tbr60702/Sensors-Final-Project/Final Report Taylor Reese.pdf

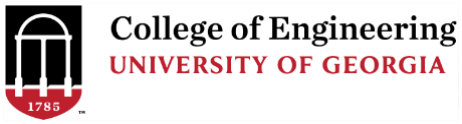
[picture p1: figure]

# Final Project Report ELEE 4230

## Taylor Reese

Final Project Report

ELEE 4230

Date: 12/05/21
Page 2 of 17

1 Table of Contents

ELEE 4230

Page 3 of 17

2 Abstract

New smoker style grills, such as a Recteq, come with controllers for grills installed on them from the factory. These controllers allow the user to set grill temperatures for the grill to maintain on its own from that point forward, as well as monitor food temperatures. The goal of this project is to create a sensor system that replicates this functionality for older smokers that did not come equipped with electronic controllers. Therefore, the goal is to create a controller that senses food and grill temperatures and can use those readings to maintain a set grill temperature without runaway overheating or choked out coals.

A fully working controller was created using an Arduino mega, motor shield, and LCD screen with a keypad for processing, control, and user interface. Two type K thermocouples were used to sense temperatures, and a fan was used to control air flow to the coals burning inside the smoker. The controller has a functioning user interface that allows users to input grill and food temperature setpoints and displays the food and grill temperatures during operation. The grill controller uses the readings to gradually adjust the grill temperature up and down to prevent runaway heating or cooling conditions by changing fan run settings based on the temperature readings.
3 Problem Identification
Unlike some new and extremely expensive grills, many
smokers or grills such as a Big Green Egg (See Figure 1) do
not come with any type of electronic controls. These types of grills rely on the person smoking on their grill to spend countless hours beside the grill adjusting the draft air intakes (See Draft Door in Figure 1) and exhaust ports (See Top in figure 1 to maintain the perfect temperature for their smoke. This is far from ideal and can allow for the grill to get way too hot or cold, ruining the cook, if it is ignored for even a few minutes. So, the problem this project attempts to solve is the instability built into smokers without any kind of electronic control. Expanding that out into a more detailed problem list,
nonelectric smokers cannot:
1. Sense food temperature

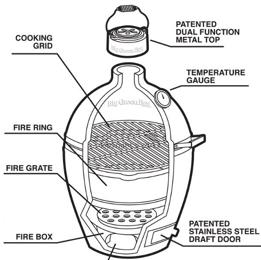
[picture p2: figure]

2. Sense grill temperature | Figure 1: Big Green Egg
3. Use food and grill temperatures to adjust air flow to coals being used to fuel the smoker.

To solve this problem, a portable/removable grill controller needs to be created that uses at least two sensors to read the food and grill temperatures, as well as have a method of determining what temperature the grill should be and controlling air flow to the coals to maintain that temperature.

ELEE 4230

Page 4 of 17

4 Sensor and Actuator Selection

As established in the problem identification section, the grill controller, at minimum, needs to sense the food temperature, grill temperature, and grill temperature setpoint. This grill controller will also sense a food temperature setpoint. Using those things, the grill controller has to control the airflow to the coals to maintain the temperature setpoint. Now, knowing what has to be sensed, the parameters can be outlined. For the food temperature sensor, it must be composed of a non-corrosive material in order to penetrate into the food without damaging itself of contaminating the food. It also must be able to sense temperatures up to approximately 200 degrees Fahrenheit and survive in environments up to 400 degrees Fahrenheit. For the grill temperature sensor, it must be able to survive in and read temperatures up to 400 degrees Fahrenheit. For sensing the grill and food temperature setpoints, a physical interaction with visual feedback must occur for a person to set each temperature.

4.1 Food and Grill Temperature Sensors

For sensing food temperatures, there were three serious options:

Measurand | Sensor Family | Sensor
Food Temperature | Resistive | RTD
| Resistive | Thermistor
| Self-Generating | Thermocouple

At this point, the thermistor is the least viable of the three sensors due to the ease of manufacturing a RTD or thermocouple into a long probe for penetrating into foods. That combined with the increased durability and range of temperature sensing in RTDs and Thermocouples eliminated thermistors for food and grill temp sensing. So, the options become:

Measurand | Sensor Family | Sensor
Food Temperature | Resistive | RTD
| Self-Generating | Thermocouple
At this point, the interchangeability and cheapness of thermocouples if one was to one day fail whereas a RTD is more expensive and less interchangeable became the deciding factor in choosing thermocouples of RTD’s. Withing thermocouples are several different types. For this project, K type include the measurand range and is the most widely available, so it was chosen.
For sensing the grill temperature, the Adafruit Accessories Thermocouple Type-K (See image 2) was chosen because it can work up to 900 degrees Fahrenheit and survive in the environment of a smoker. For sensing the food temperature, a Prosense Thermocouple with a 6” probe was chosen to because the material is stainless steel and safe up to 400 degrees Fahrenheit, which is above smoking temperatures.

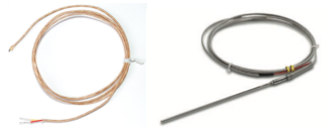
[picture p3: figure]

Image 2: Adafruit Accessories Thermocouple Type-K Image 3: Prosense Type K Thermocouple 6” Probe

ELEE 4230

Page 5 of 17

4.2 Grill and Food Temperature Setpoint Sensing

Keeping in mind that the sensing method must show a visual indicator of the setpoint, the options for sensing become more limited. The viable options are:

Measurand | Sensor Family | Sensor
Temperature Setpoints | Resistive | Potentiometer
| Capacitive | Thermistor
| Digital | Buttons + LCD Screen

The capacitor was cut from the option list because it required the most from a sensor conditioning standpoint to transform the change in capacitance into a change in frequency and then into a digital signal whereas a potentiometer is simple to linearize and condition. The options then become:

Measurand | Sensor Family | Sensor
Temperature Setpoints | Resistive | Potentiometer
| Digital | LCD Shield + Buttons

While the potentiometer would work, it was eliminated because it was determined that an LCD screen would allow for more user interaction and confidence in the right value being set for each temperature. It would also allow for more interactive coding where real time temperatures could be displayed, so an LCD shield with a keypad was chosen. The DFRobot 1602 LCD with Keypad shown below meets that criterion and can easily stack on top of an Arduino Uno or Mega.

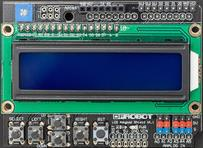
[picture p4: figure]

Image 4: DFRobot Gravity: 1602 LCD Keypad Shield for Arduino

4.3 Air Flow Control

Here there were really only two options (see table blow) which can be summed up as retaining the original valve style of natural air flow control, but controlling how open and shut the valve is, or making valves always narrow and forcing air through when needed.

Factor Controlled | Method | Actuator
Air Flow | Controlling Natural Air Convection | Electronic Air Intake and Exhaust Valves
| Forced Air | Air Intake Fan

ELEE 4230

Page 6 of 17

Ultimately, the deciding factor was that controlling natural air convection only works when there is a steady enough fire to have good convection. If the fire begins to die out, control is reduced. The forced air method does not encounter its problem. It relies on fixed, narrow valves and a fan forcing air through as needed for the coals to burn. Ultimately, a NMB Technologies DC Centrifugal Blower was chosen because of its 10.5 CFM air flow capacity and 70,000 Hour life. Temperature was not a consideration as it will be mounted external to the grill and have cool air flowing through it.

4.4 Conclusion and Final Sensor/Actuator List

Parameter | Importance | Final Method | Justification
Food Temperature | To measure doneness | Type K Thermocouple | • Cheap • Interchangeable • Probe Shape
Grill Temperature | To know if the grill needs to increase or decrease temperature | Type K Thermocouple | • Cheap • Interchangeable • Probe Shape
Temperature Setpoints | To know what temperature the grill should maintain | LCD Screen with Keypad | • No signal conditioning needed • Visual Feedback
Air Flow Control | To control the rate at which coals burn which controls temperature | Forced Air | • Provides more control at low temperatures • Narrow valves stop natural convection at high temps

5 Signal Conditioning

5.1 Thermocouple Signal Conditioning

Thermocouples are self-generating sensors that produce a temperature dependent voltage. Each thermocouple requires 4 things in signal conditioning: filtering, linearization, cold junction compensation, and analog to digital conversion. In order to simplify the circuit, and increase accuracy and dependability, especially with human food involved, a thermocouple amplifier was chosen to accomplish this. Therefore, each thermocouple is wired to a MAX31856 Thermocouple Amplifier. The MAX31856 is powered by 5V and starts out by converting the thermocouple voltage to a digital signal by first amplifying the signal. The MAX31856 accepts ±78.125mV input and amplifies that signal to 0-5V for its analog to digital converter. The amplified signal is then run through notch filtering at 50Hz and 60Hz and their harmonics to eliminate noise from other electronic sources. Last, the ADC converts the analog signal into a 19-bit digital value for a high resolution despite a high range, specifically 0.005 degrees Fahrenheit for a K-type thermocouple.
Most unique to thermocouples, is the need for cold junction compensation. Each junction between metals produces a voltage, so thermocouples produce a combined output voltage of the junction at the measurand end, and the circuit end of a thermocouple. To calculate the measurand end’s voltage, cold-junction compensation must be performed to remove the circuit end of the thermocouple’s voltage contribution. The MAX31856 has an internal semiconductor (transistor)

ELEE 4230

Page 7 of 17

based temperature sensor that has an accuracy of ±1.26 degrees Fahrenheit which then goes through the same ADC conversion process as the thermocouple. Both the previous overall 19-bit digital value and the cold-junction 19-bit digital value are then used in a look up table (LUT) programmed into the MAX31856 to compensate for the cold junction as well as nonlinearities. This is possible because all type K thermocouples produce the same response to temperature.
Finally, the MAX31856 transmits this final temperature reading over a four-pin serial peripheral interface (SPI): serial data out, serial data in, chip select, and serial clock. These pin functions can be programmed into any digital input/output on the Arduino for communication.

5.2 Keypad Buttons on LCD Shield

The buttons on the LCD shield are powered automatically by the LCD Hat being plugged into the Arduino and are wired as a 5-step voltage divider (see schematic below) to Analog Pin 0

Button | Analog Value
Right | 0
Up | 204
Down | 406
Left | 609
Select | 824

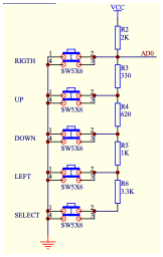
[picture p5: figure]

Image 5: Button Schematic and Analog Values

5.3 DC Centrifugal Blower

The Centrifugal blower required no signal conditioning other than a motor hat driver to accommodate its .29A nominal current. This was accomplished by placing an Adafruit Motor Shield v2.3 between the Arduino and LCD Shield with the blower wired to the M1 output.

6 Logic Implementation

6.1 Hardware Selection

The decision was made to use a microcontroller over logic chips for two main reasons: the need for a user interface, and for programmability. With logic chips and circuit-based logic in general, there is little room for flexibility in testing and tuning the logic to test results. Knowing these things would be valuable, alongside the heavy need for code, proved the need for a programmable microcontroller. Arduino was chosen for the microcontroller over Raspberry Pi for price, ease of

ELEE 4230

Page 8 of 17

setup, and ease of programming. The specific Arduino chosen was the Arduino Mega 2560 for the processing and logic implementation over an Arduino Uno because 14 digital pins were needed, and the Arduino Uno only offers 13 digital pins.

6.2 Code Implementation

As shown in the flowchart below, the code is structured to work through three main stages:
1. Determine the Food and Grill Setpoints
2. Reading and Displaying Actual Food and Grill Temperatures
3. Running the fan to maintain the grill temperature setpoint

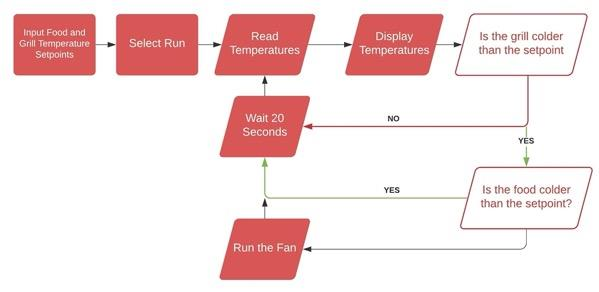
[picture p6: figure]

Image 6: Overall Code Structure Flowchart This is all done via functions inside of an LCD Menu. The LCD Menu operates by initially cycling through three main screens by pressing the right button. Buttons are read to set variable “y” to one of 5 values depending on which button is pressed in the void function “button_read() seen below.

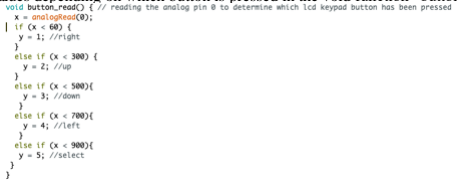
[picture p7: figure]

Image 7: Button Read function The correct screen is chosen to be displayed by the void function “lcd_case_counter()” (see below).

ELEE 4230

Page 9 of 17

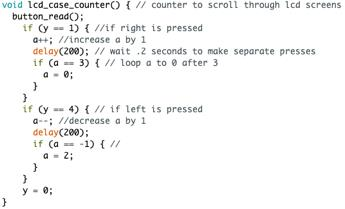
[picture p8: figure]

Image 8: LCD Screen Case Counter Then, in the void loop function, a series of “if a is equal to…” are used to determine the correct screen to be displayed. Screen 1 Displays “Food Setpoint” on first line and the food setpoint variable on the second line, which can be changed by pressing the up or down buttons on the keypad. Here is the code for Screen 1 which is inside the void loop function:

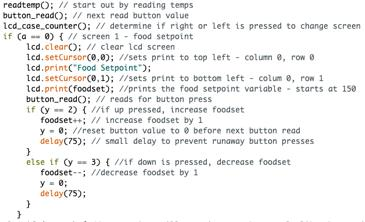
[picture p9: figure]

Image 9: Code for Screen 1 Next comes the code for Screen 2, the “Grill Setpoint” screen. Its code is the exact same as Screen 1’s code except it prints “Grill Setpoint” and the “grillset” variable. Screen 3 asks if the user would like to begin running the controller. If select is pressed, the controller will loop indefinitely in a cycle where it reads the food and grill temperature, displays the food and grill temperature, determines the setting for if the fan needs to be ran and for how long, and then runs the correct fan setting. Starting with reading temperatures, the code communicates with the MAX31856 chips using SPI communication which is initialized at the very beginning of the code with the following:

Image 10: MAX31856 Initialization Code Then the void function “readtemp()” shown below is used to read the temperatures, and then convert them to Fahrenheit

ELEE 4230

Page 10 of 17

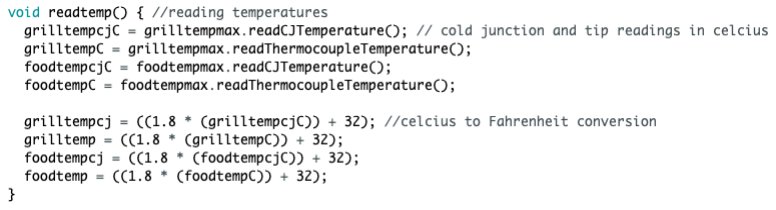
[picture p10: figure]

Image 11: Temperature Reading Function After that, the code displays the temperatures in a similar manner as before. Then, it runs the void function “fan_case_counter()” (see below). The point of choosing a variety of cases is that constantly blowing air onto the coals will create an inferno, so a gradual approach is needed. As temperatures get closer to the setpoint, the fan should stoke the fire less and less. Also, if the food reaches its setpoint temperature, the grill should not be stoked at all to help prevent overcooking.

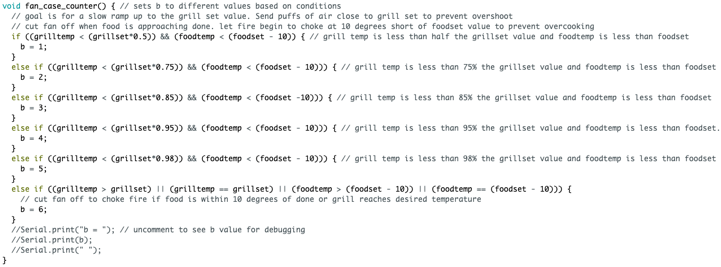
[picture p11: figure]

Image 11: Fan Case Counter Next, the void function “fan_control()” is ran to actually turn on the fan for one of 6 durations: 15 seconds, 7.5 seconds, 5 seconds, 2.5 seconds, 1 second, 0 seconds. The duration is chosen by the b value set in “fan_case_counter()”. Here is the code that does that on the left:

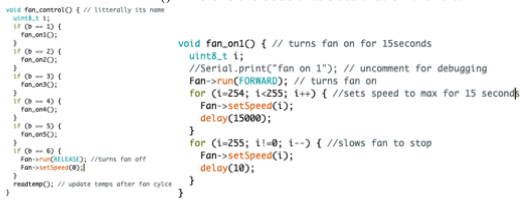
[picture p12: figure]

Image 12: Fan Control Function (LEFT) and Example Fan ON Function (RIGHT)
The functions “fan_on1(), fan_on2(), fan_on3(), fan_on4(), and fan_on5()” are written exactly like the “fan_on1()” function (See Image 12), except with different delays to change the run time

ELEE 4230

Page 11 of 17

between the times listed above, in that order. Once all this is added together, you get the full screen 3 and grill control code in the void loop function as shown here:

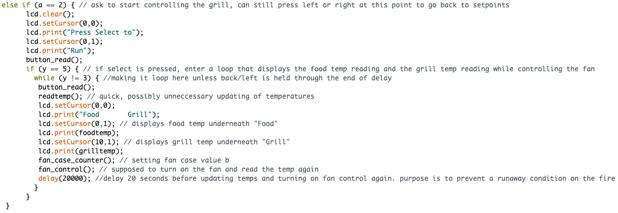
[picture p13: figure]

For the full code, please see the GitHub link in the appendix.

7 Physical Considerations

There are two main physical considerations for this project that require looking into. The first is the obvious, temperature. Grills get hot. Fortunately, this controller is used for long term smoking, which happens at temperatures less than 350 degrees Fahrenheit, so both sensors must be able to exceed that upper limit, and they do. The other consideration that had to be kept in mind was the food ruining the food probe sensor by corroding it or the food probe sensor contaminating the food. For this reason, a stainless-steel probe was chosen to prevent these issues. For more information on the physical parameters everything had to meet, see the checklists in the appendix.
8 Results

8.1 Final Product

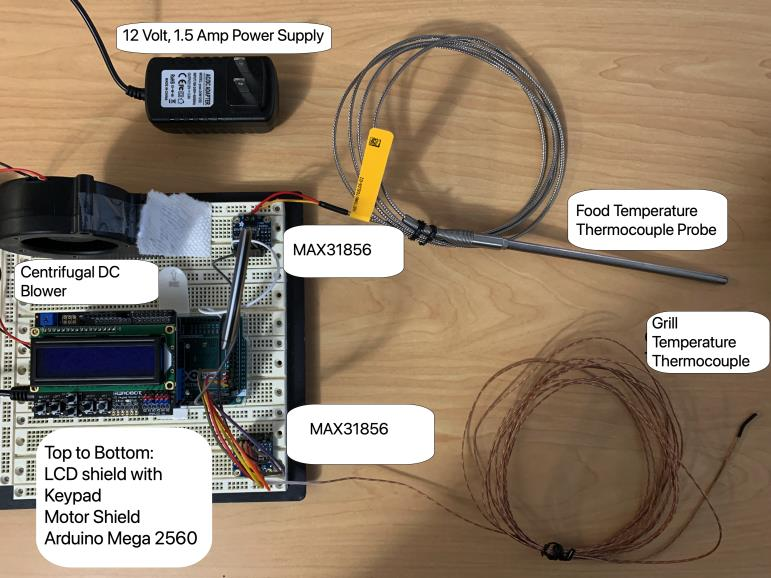
[picture p14: figure]

ELEE 4230

Page 12 of 17

8.2 Final Testing Results

For testing the temperature readings, the temperature had to be within 5 degrees Fahrenheit and run the fan for the correct amount of time. An oven was used to heat the thermocouples and a store bought digital thermometer was used to confirm the readings.

Fan Case Tested | Grill Setpoint | Food Setpoint | Grill Thermocouple Reading | Food Thermocouple Reading | Grill Actual | Food Actual | Fan Run as expected?
1 | 300 | 200 | 120 | 68 | 121 | 68 | Yes
2 | 300 | 200 | 216 | 68 | 214 | 68 | Yes
3 | 300 | 200 | 243 | 68 | 241 | 68 | Yes
4 | 300 | 200 | 270 | 68 | 273 | 68 | Yes
5 | 300 | 200 | 288 | 68 | 292 | 68 | Yes
6 | 300 | 200 | 307 | 68 | 305 | 68 | Yes
6 | 300 | 200 | 68 | 321 | 69 | 325 | Yes

After testing and getting results, it is shown that the thermocouple readings are accurate, the LCD displays them correctly, the menu selection works, and the correct fan control function is selected and ran in the seven main conditions than can occur. Therefore, the code works exactly as expected.
9 Revision 2

For a final revision, two things need to occur. The first one is replacing the Arduino with a multicore processor. The single core Arduino is only capable of doing one task at a time, and while that is sufficient for this project, it is not ideal either. Having multiple cores would allow for multiple things the run at once. That means the temperatures on the LCD screen could update while the fan control function is running, making the operation and code run more smoothly. The second thing is the overall construction of the controller. It cannot survive long term on a breadboard, so a second revision would see it transition from a breadboard to a solderable perfboard or PCB that a case could be built around.
10 References

The only resource used in completing this project was Adafruit’s MAX31856 Wiring and Test guide (see Appendix for link). The Wiring and Test guide goes through and explains how to communicate with the MAX31856 chip to get readings, and it was used to include the correct libraries in the code and to talk to the chip. The entire structure of how the code used the MAX31856 readings to control the fan was completely original, as well as the user interface, and all other relevant coding knowledge on the project came from previous projects such as the XY Plotter in Design Methodology or was figured out on this project using trial and error.

ELEE 4230

Page 13 of 17

11 Appendix

11.1 Project Github Page

https://github.com/tbr60702/Sensors-Final-Project

11.2 Final Code

https://github.com/tbr60702/Sensors-Final-Project/blob/main/Grill_Controller_Final.ino

11.3 Sensors Checklist

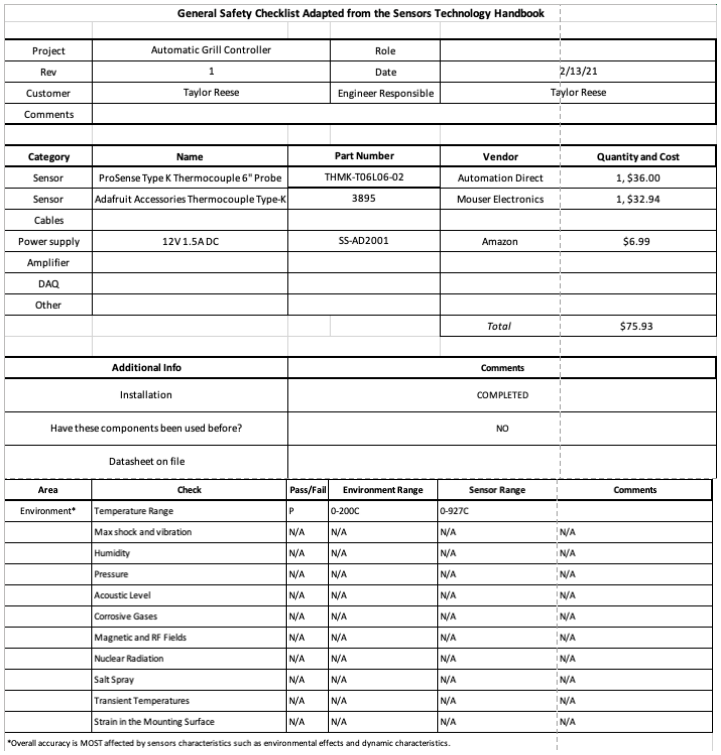
[picture p15: figure]

ELEE 4230

Date: 12/05

/2
1
Page 14 of 17

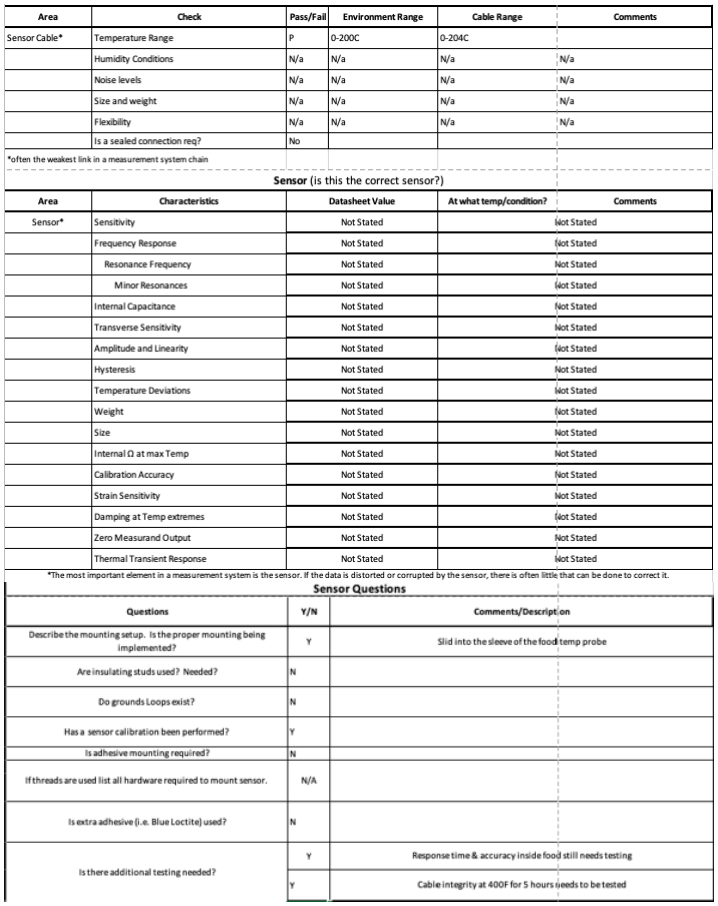
[picture p16: figure]

ELEE 4230

Date: 12/05

/2
1
Page 15 of 17

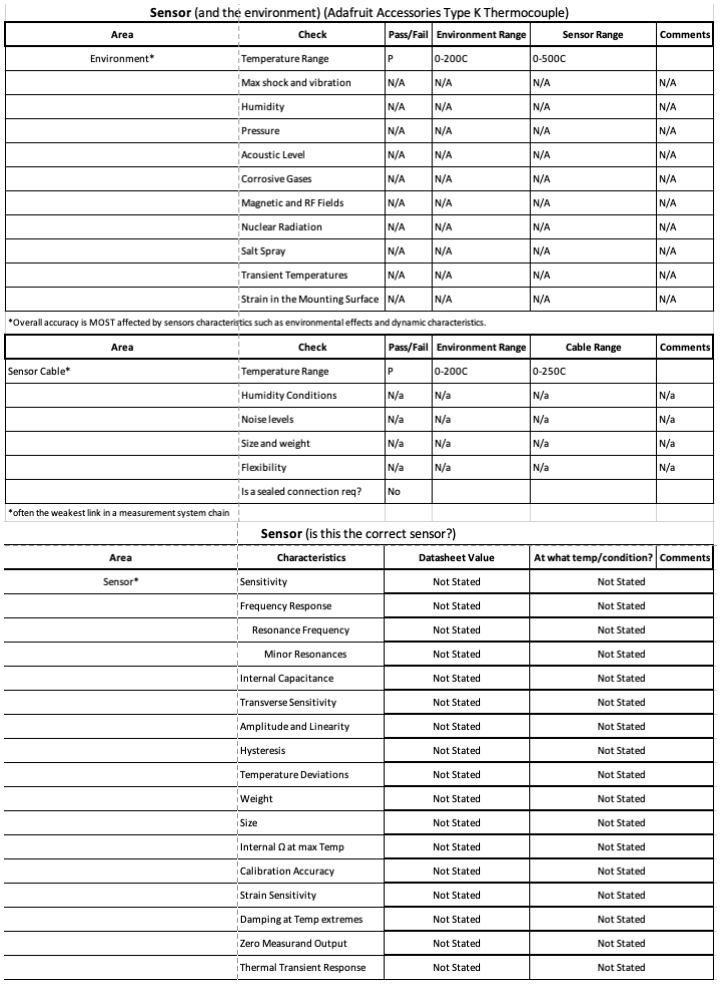
[picture p17: figure]

ELEE 4230

Date: 12/05

/2
1
Page 16 of 17

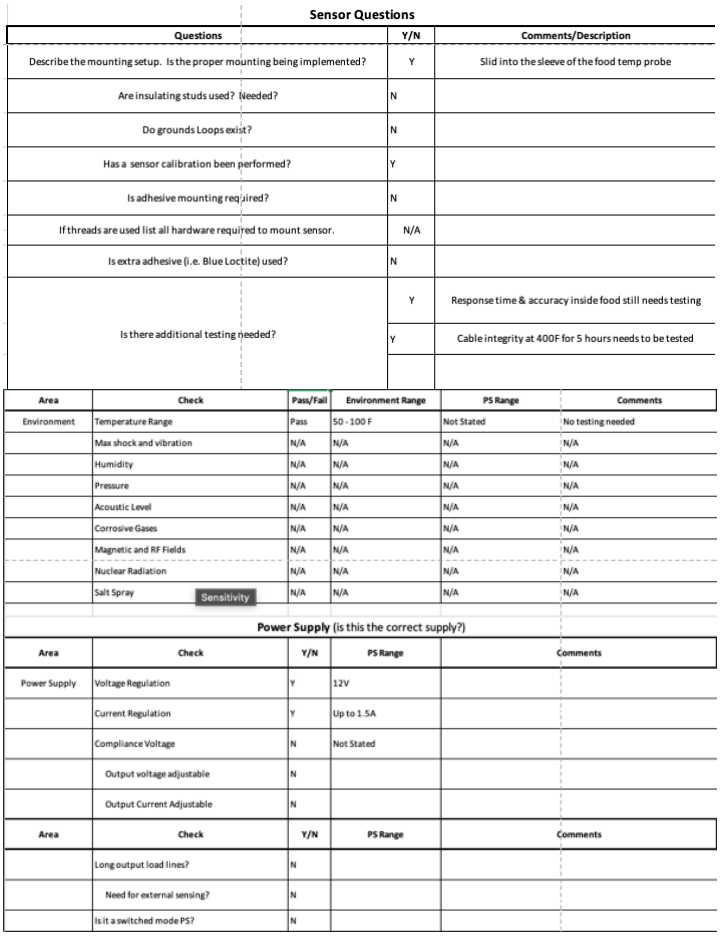
[picture p18: figure]

ELEE 4230

Page 17 of 17

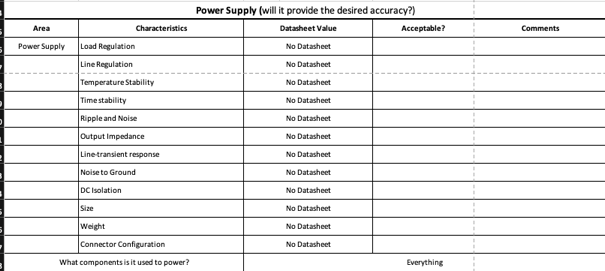
[picture p19: figure]

11.4 MAX31856 Wiring and Test Guide

https://learn.adafruit.com/adafruit-max31856-thermocouple-amplifier/wiring-and-test
