tbr60702/Sensors-Final-Project/Hardware Update - Taylor Reese.pdf

## Final Project - Hardware Update

## Taylor Reese

## Sensors and Transducers

ELEE 4230- Hardware Update

Taylor Reese

Date: 11/19/21
Page 2 of 8

Proposed Bill of Materials

Major Purchase Items | Possible Vendors
Food Probe (RTD) | Amazon, DigiKey
Smoker Temperature Sensor (RTD) | Amazon, DigiKey
Arduino Uno | Amazon
1” Circular Fan | Amazon

Final Bill of Materials

Item | Quantity | Vendor | Price ($)
Arduino Mega | 1 | Arduino | 54.82
Food Probe (Type K Thermocouple) | 1 | Automation Direct | 36.00
Smoker Temperature Sensor (Type K Thermocouple) | 1 | Mouser Electronics | 32.94
Centrifugal Fan | 1 | Mouser Electronics | 21.59
MAX38156 | 2 | Amazon | 18.34
Perfboard | 1 | Amazon | 11.99
DFRobot LCD screen | 1 | Amazon | 14.58

Taylor Reese

Page 3 of 8

Breadboard Wires | 1 | Amazon | 9.99
Dupont Wires | 1 | Amazon | 6.98
Power Supply | 1 | Amazon | 7.55
Adafruit Motor/Stepper/Servo Shield | 1 | Amazon | 23.85
| | | Total = $256.97

“Indisputable Photographic Evidence”

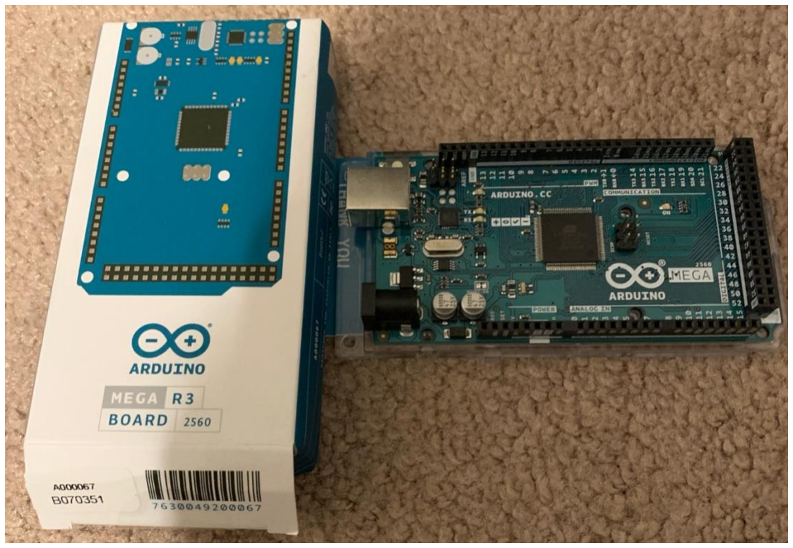
[picture p21: figure]

Image 1: Arduino MEGA

Taylor Reese

Page 4 of 8

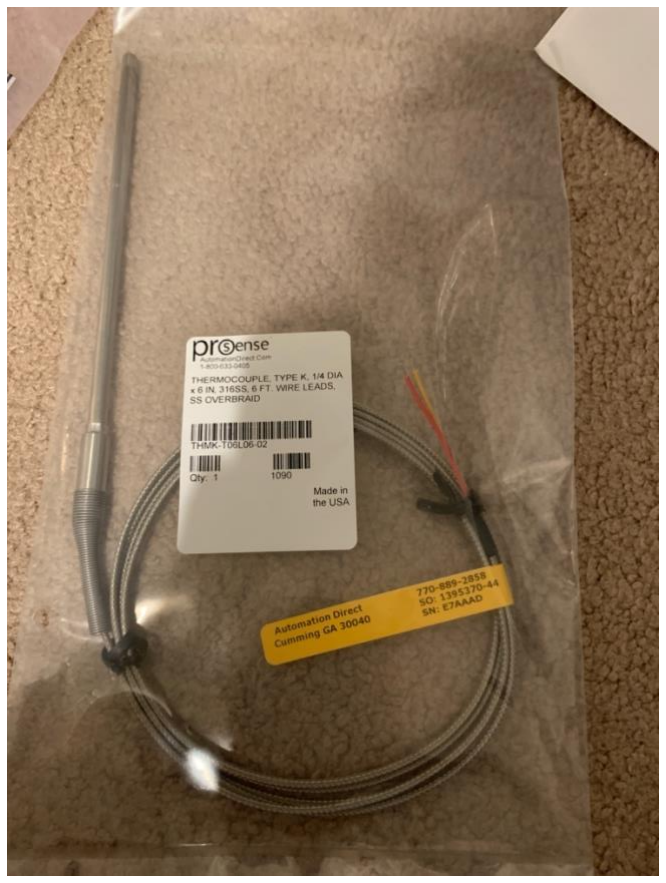
[picture p22: figure]

Image 2: Food Temperature Probe

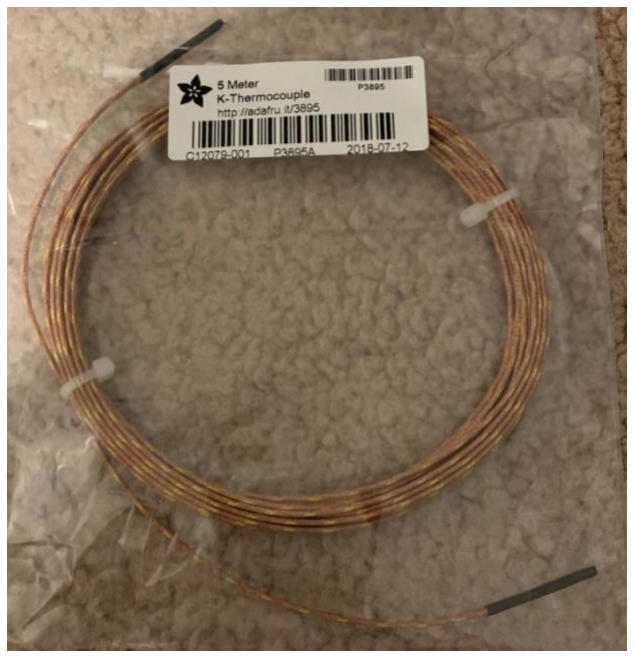
[picture p23: figure]

Image 3: Smoker Temperature Probe

Taylor Reese

Page 5 of 8

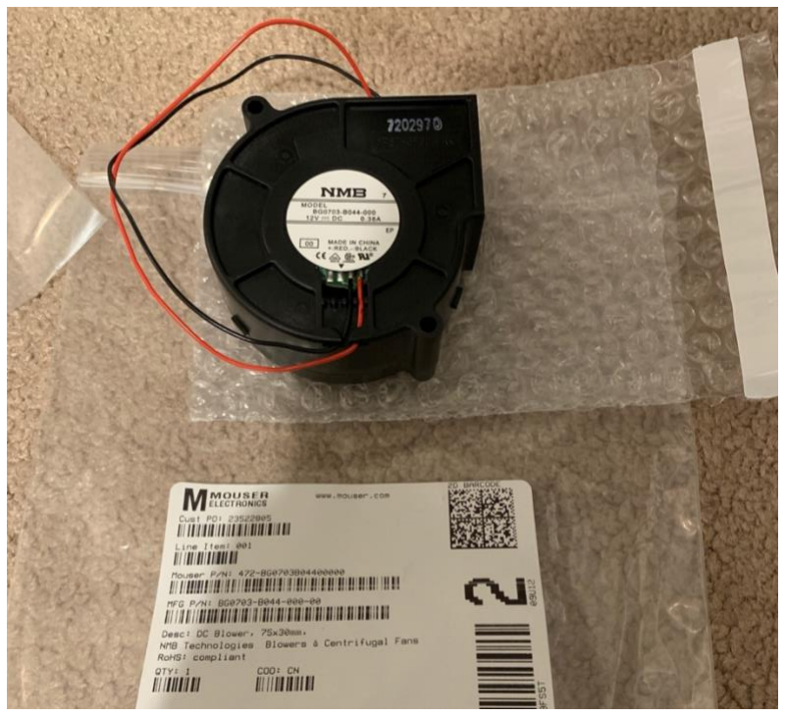
[picture p24: figure]

Image 4: Centrifugal Fan

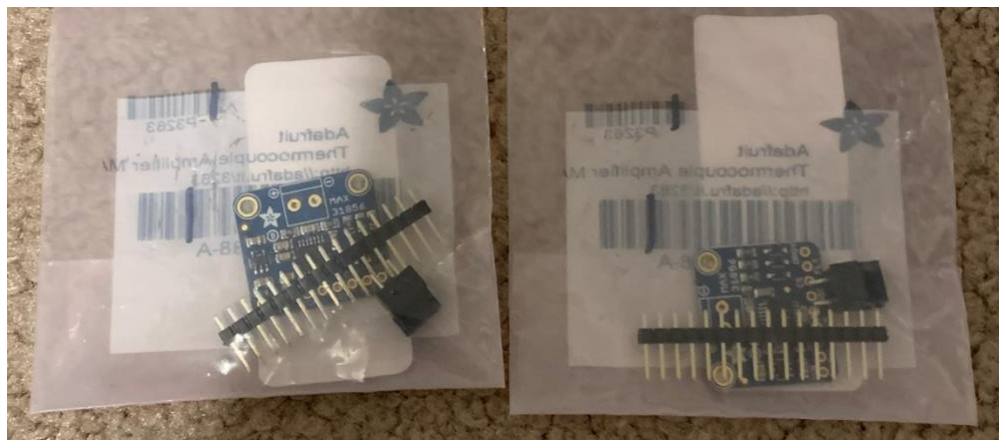
[picture p25: figure]

Image 5: MAX38156 Breakout Board

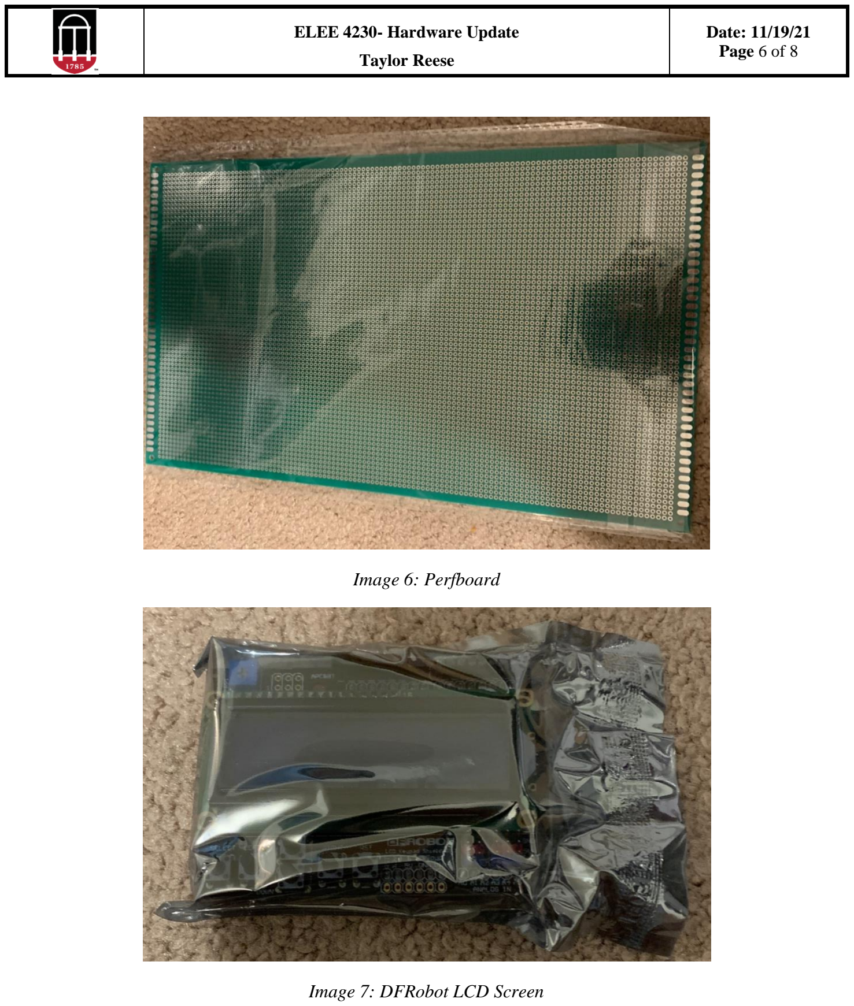
[picture p26: page 6]

Taylor Reese

Page 6 of 8

Image 6: Perfboard

Image 7: DFRobot LCD Screen

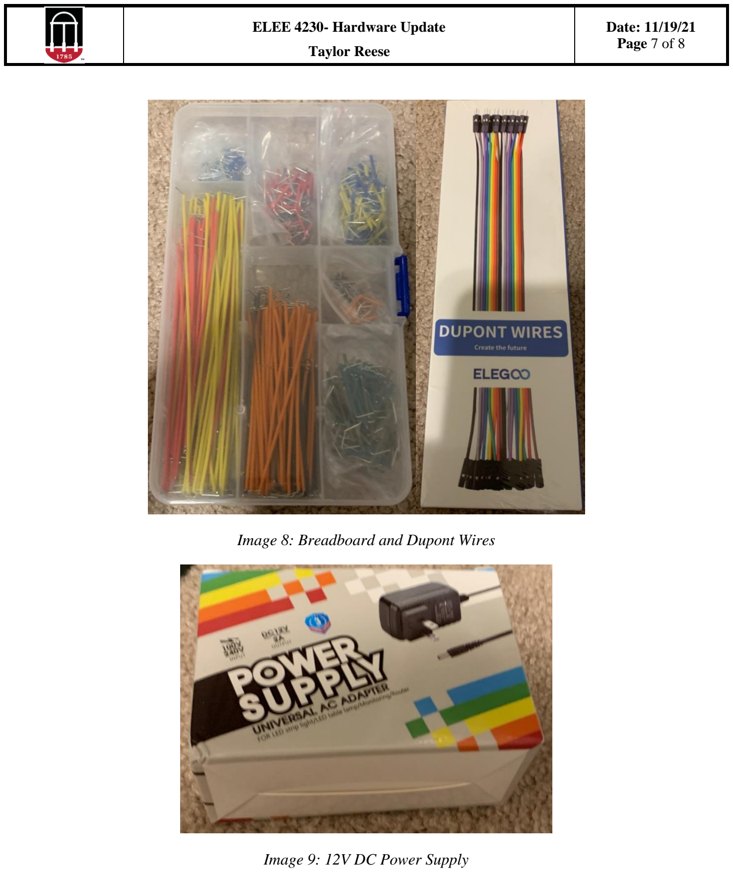
[picture p27: page 7]

Taylor Reese

Page 7 of 8

Image 8: Breadboard and Dupont Wires

Image 9: 12V DC Power Supply

Taylor Reese

Page 8 of 8

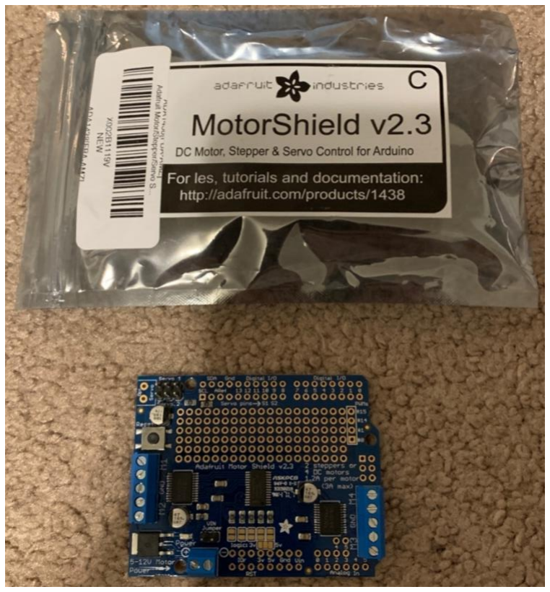
[picture p28: figure]

Image 10: Adafruit MotorSheild
